xinaovo/TommyDSP/README.md

# TommyDSP

An audio DSP platform based on RP2350 microcontroller
