xinaovo/TommyDSP/hardware/TommyDSP/TommyDSP.kicad_pcb

## KiCad design hardware/TommyDSP/TommyDSP.kicad_pcb (2026-04-24)

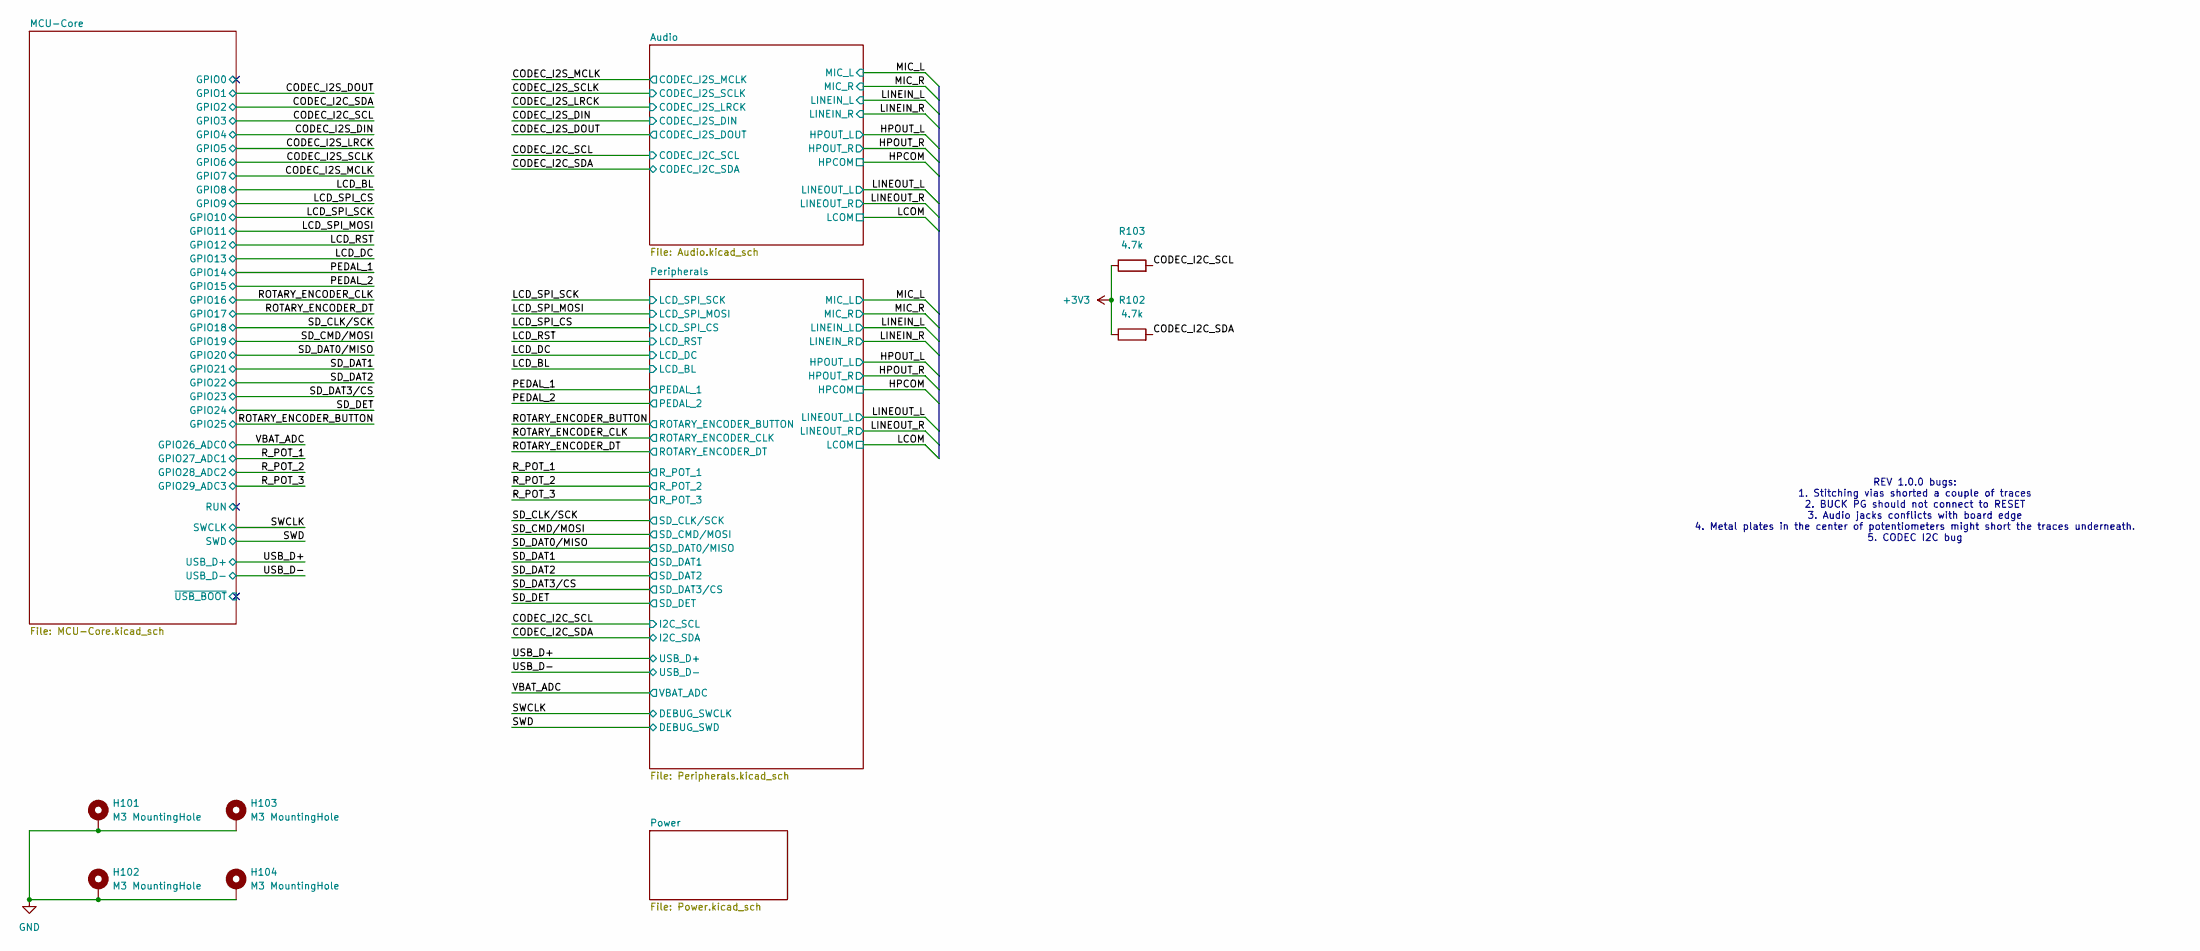
[picture p1: schematic TommyDSP.kicad_sch]

Parts:
H101, H102, H103, H104: M3 MountingHole; MountingHole_3.2mm_M3_DIN965_Pad_TopBottom
R102, R103: 4.7k; R_0603_1608Metric

Connections:
+3V3: R102.1, R103.1; also elsewhere on the board
/CODEC_I2C_SCL: R103.2; also elsewhere on the board
/CODEC_I2C_SDA: R102.2; also elsewhere on the board
GND: H101.1 (1_1), H102.1 (1_1), H103.1 (1_1), H104.1 (1_1); also elsewhere on the board

Notes on the sheet:
REV 1.0.0 bugs: 1. Stitching vias shorted a couple of traces 2. BUCK PG should not connect to RESET 3. Audio jacks conflicts with board edge 4. Metal plates in the center of potentiometers might short the traces underneath. 5. CODEC I2C bug

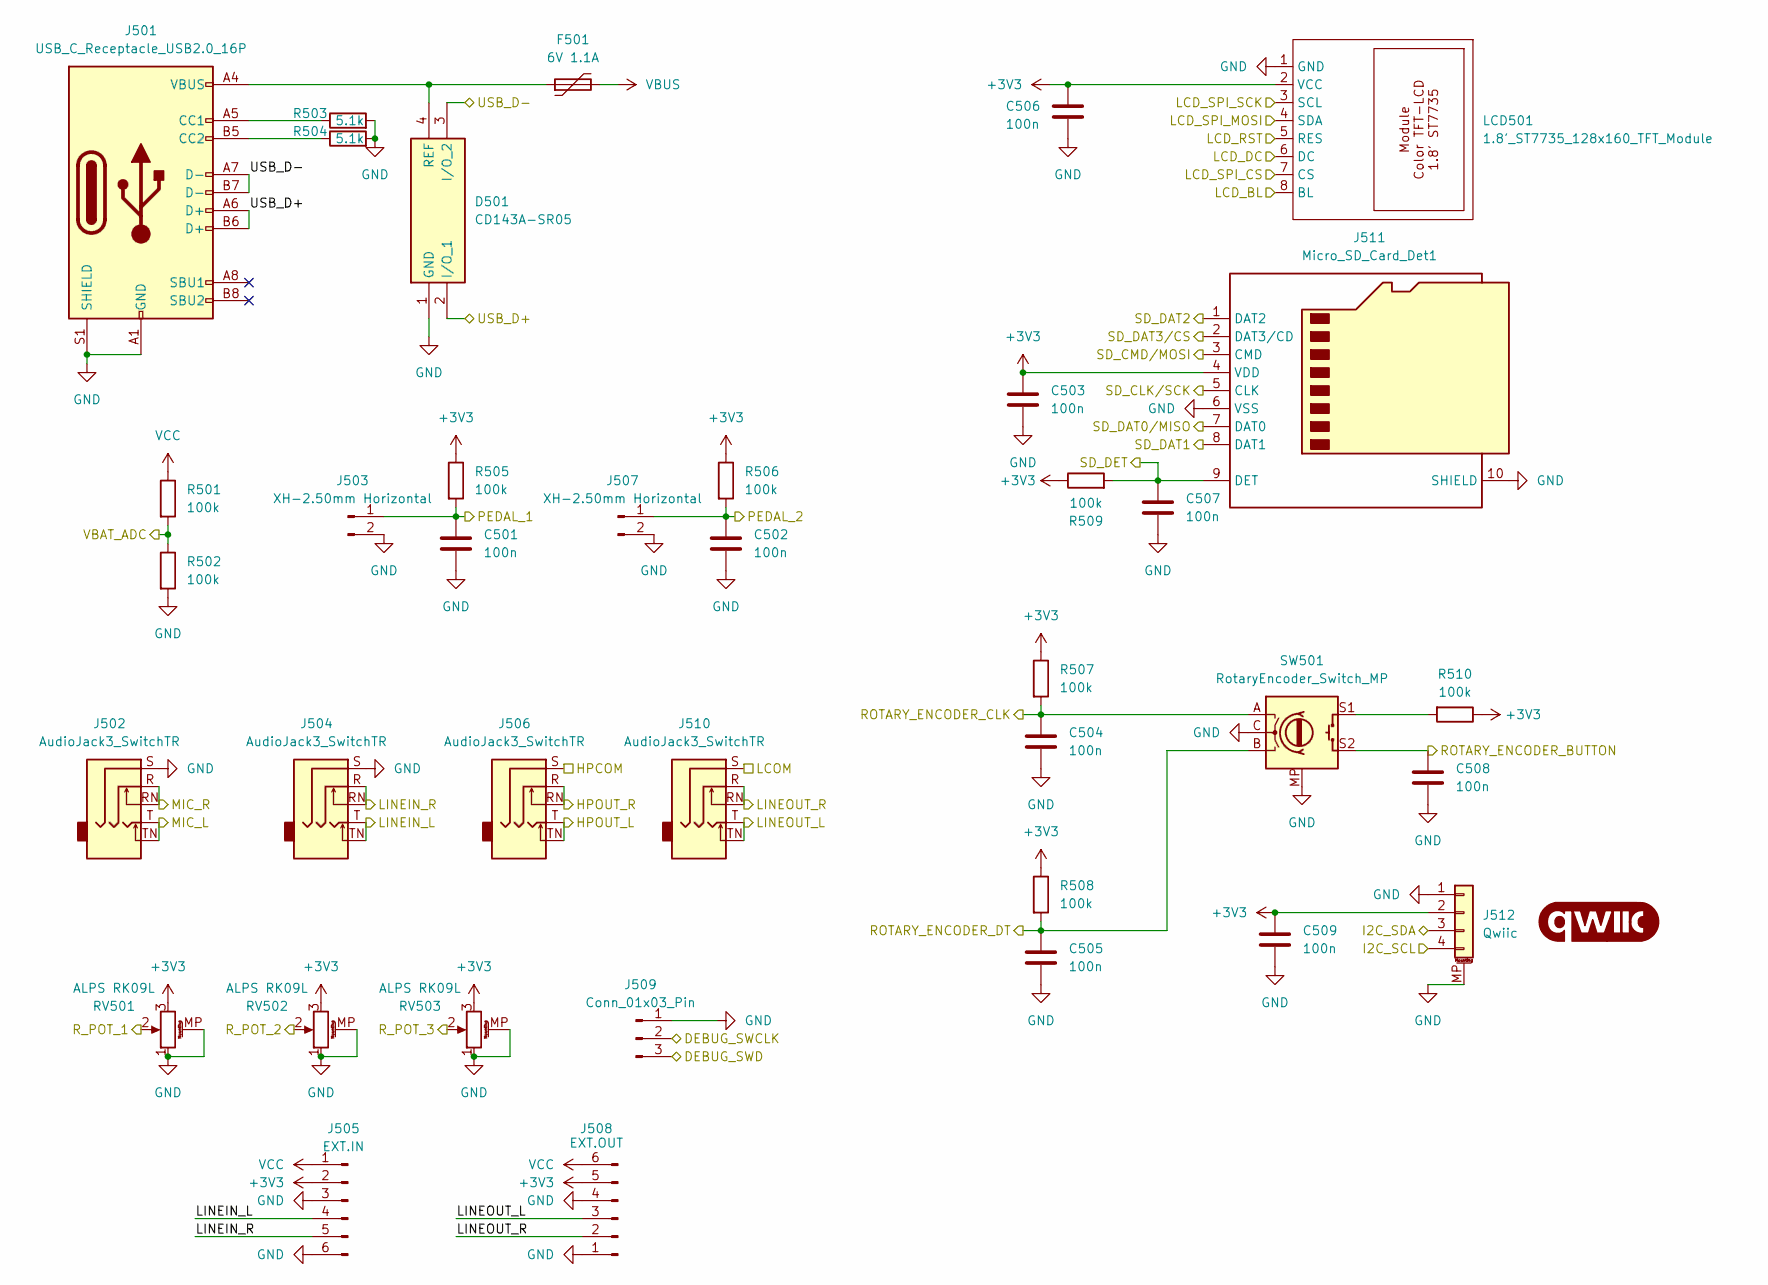
[picture p2: schematic Peripherals.kicad_sch, TommyDSP]

Parts:
C501, C502, C503, C504, C505, C506, C507, C508, C509: 100n; C_0603_1608Metric
D501: CD143A-SR05; CD143ASR05; Manufacturer_Part_Number CD143A-SR05; Mouser Part Number 652-CD143A-SR05
F501: 6V 1.1A; Fuse_1206_3216Metric
G501: qwiic_Logo; qwiic_5.5mm
J501: USB_C_Receptacle_USB2.0_16P; USB_C_Receptacle_G-Switch_GT-USB-7010ASV
J502, J504, J506, J510: AudioJack3_SwitchTR; Jack_3.5mm_CUI_SJ1-3525N_Horizontal
J503, J507: XH-2.50mm Horizontal; JST_EH_S2B-EH_1x02_P2.50mm_Horizontal
J505: EXT.IN; JST_XH_S6B-XH-A-1_1x06_P2.50mm_Horizontal
J508: EXT.OUT; JST_XH_S6B-XH-A-1_1x06_P2.50mm_Horizontal
J509: Conn_01x03_Pin; PinHeader_1x03_P2.54mm_Vertical
J511: Micro_SD_Card_Det1; TF01A
J512: Qwiic; JST_SH_SM04B-SRSS-TB_1x04-1MP_P1.00mm_Horizontal
LCD501: 1.8'_ST7735_128x160_TFT_Module
R501, R502, R505, R506, R507, R508, R509, R510: 100k; R_0603_1608Metric
R503, R504: 5.1k; R_0603_1608Metric
RV501, RV502, RV503: ALPS RK09L; Potentiometer_Alps_RK09K_Single_Vertical
SW501: RotaryEncoder_Switch_MP; RotaryEncoder_Alps_EC11E-Switch_Vertical_H20mm

Connections:
+3V3: C503.1, C506.1, C509.1, J505.2, J508.5, J511.4 (VDD), J512.2, LCD501.2 (VCC), R505.1, R506.1, R507.1, R508.1, R509.1, R510.1, RV501.3, RV502.3, RV503.3; also elsewhere on the board
/CODEC_I2C_SCL: J512.4; also elsewhere on the board
/CODEC_I2C_SDA: J512.3; also elsewhere on the board
/HPOUT_L: J506.T, J506.TN; also elsewhere on the board
/HPOUT_R: J506.R, J506.RN; also elsewhere on the board
/LCD_BL: LCD501.8 (BL); also elsewhere on the board
/LCD_DC: LCD501.6 (DC); also elsewhere on the board
/LCD_RST: LCD501.5 (RES); also elsewhere on the board
/LCD_SPI_CS: LCD501.7 (CS); also elsewhere on the board
/LCD_SPI_MOSI: LCD501.4 (SDA); also elsewhere on the board
/LCD_SPI_SCK: LCD501.3 (SCL); also elsewhere on the board
/LINEIN_L: J504.T, J504.TN, J505.4; also elsewhere on the board
/LINEIN_R: J504.R, J504.RN, J505.5; also elsewhere on the board
/LINEOUT_L: J508.3, J510.T, J510.TN; also elsewhere on the board
/LINEOUT_R: J508.2, J510.R, J510.RN; also elsewhere on the board
/MIC_L: J502.T, J502.TN; also elsewhere on the board
/MIC_R: J502.R, J502.RN; also elsewhere on the board
/PEDAL_1: C501.1, J503.1, R505.2; also elsewhere on the board
/PEDAL_2: C502.1, J507.1, R506.2; also elsewhere on the board
/ROTARY_ENCODER_BUTTON: C508.1, SW501.S2; also elsewhere on the board
/ROTARY_ENCODER_CLK: C504.1, R507.2, SW501.A; also elsewhere on the board
/ROTARY_ENCODER_DT: C505.1, R508.2, SW501.B; also elsewhere on the board
/R_POT_1: RV501.2; also elsewhere on the board
/R_POT_2: RV502.2; also elsewhere on the board
/R_POT_3: RV503.2; also elsewhere on the board
/SD_CLK/SCK: J511.5 (CLK); also elsewhere on the board
/SD_CMD/MOSI: J511.3 (CMD); also elsewhere on the board
/SD_DAT0/MISO: J511.7 (DAT0); also elsewhere on the board
/SD_DAT1: J511.8 (DAT1); also elsewhere on the board
/SD_DAT2: J511.1 (DAT2); also elsewhere on the board
/SD_DAT3/CS: J511.2 (DAT3/CD); also elsewhere on the board
/SD_DET: C507.1, J511.9 (DET), R509.2; also elsewhere on the board
/SWCLK: J509.2; also elsewhere on the board
/SWD: J509.3; also elsewhere on the board
/USB_D+: D501.2 (I/O_1), J501.A6 (D+_A6), J501.B6 (D+_B6); also elsewhere on the board
/USB_D-: D501.3 (I/O_2), J501.A7 (D-_A7), J501.B7 (D-_B7); also elsewhere on the board
/VBAT_ADC: R501.2, R502.1; also elsewhere on the board
GND: C501.2, C502.2, C503.2, C504.2, C505.2, C506.2, C507.2, C508.2, C509.2, D501.1 (GND), J501.A1 (GND_A1), J501.A12 (GND_A12), J501.B1 (GND_B1), J501.B12 (GND_B12), J501.S1 (SHIELD), J501.SH (SHIELD_S1), J502.S, J503.2, J504.S, J505.3, J505.6, J506.S, J507.2, J508.1, J508.4, J509.1, J510.S, J511.6 (VSS), J511.10 (SHIELD), J512.1, J512.MP (MountPin), LCD501.1 (GND), R502.2, R503.2, R504.2, RV501.1, RV501.MP (MountPin), RV502.1, RV502.MP (MountPin), RV503.1, RV503.MP (MountPin), SW501.C, SW501.MP; also elsewhere on the board
unnamed: D501.4 (REF), F501.1, J501.A4 (VBUS_A4), J501.A9 (VBUS_A9), J501.B4 (VBUS_B4), J501.B9 (VBUS_B9)
unnamed: J501.A5 (CC1_A5), R503.1
unnamed: J501.B5 (CC2_B5), R504.1
unnamed: R510.2, SW501.S1
VBUS: F501.2; also elsewhere on the board
VCC: J505.1, J508.6, R501.1; also elsewhere on the board

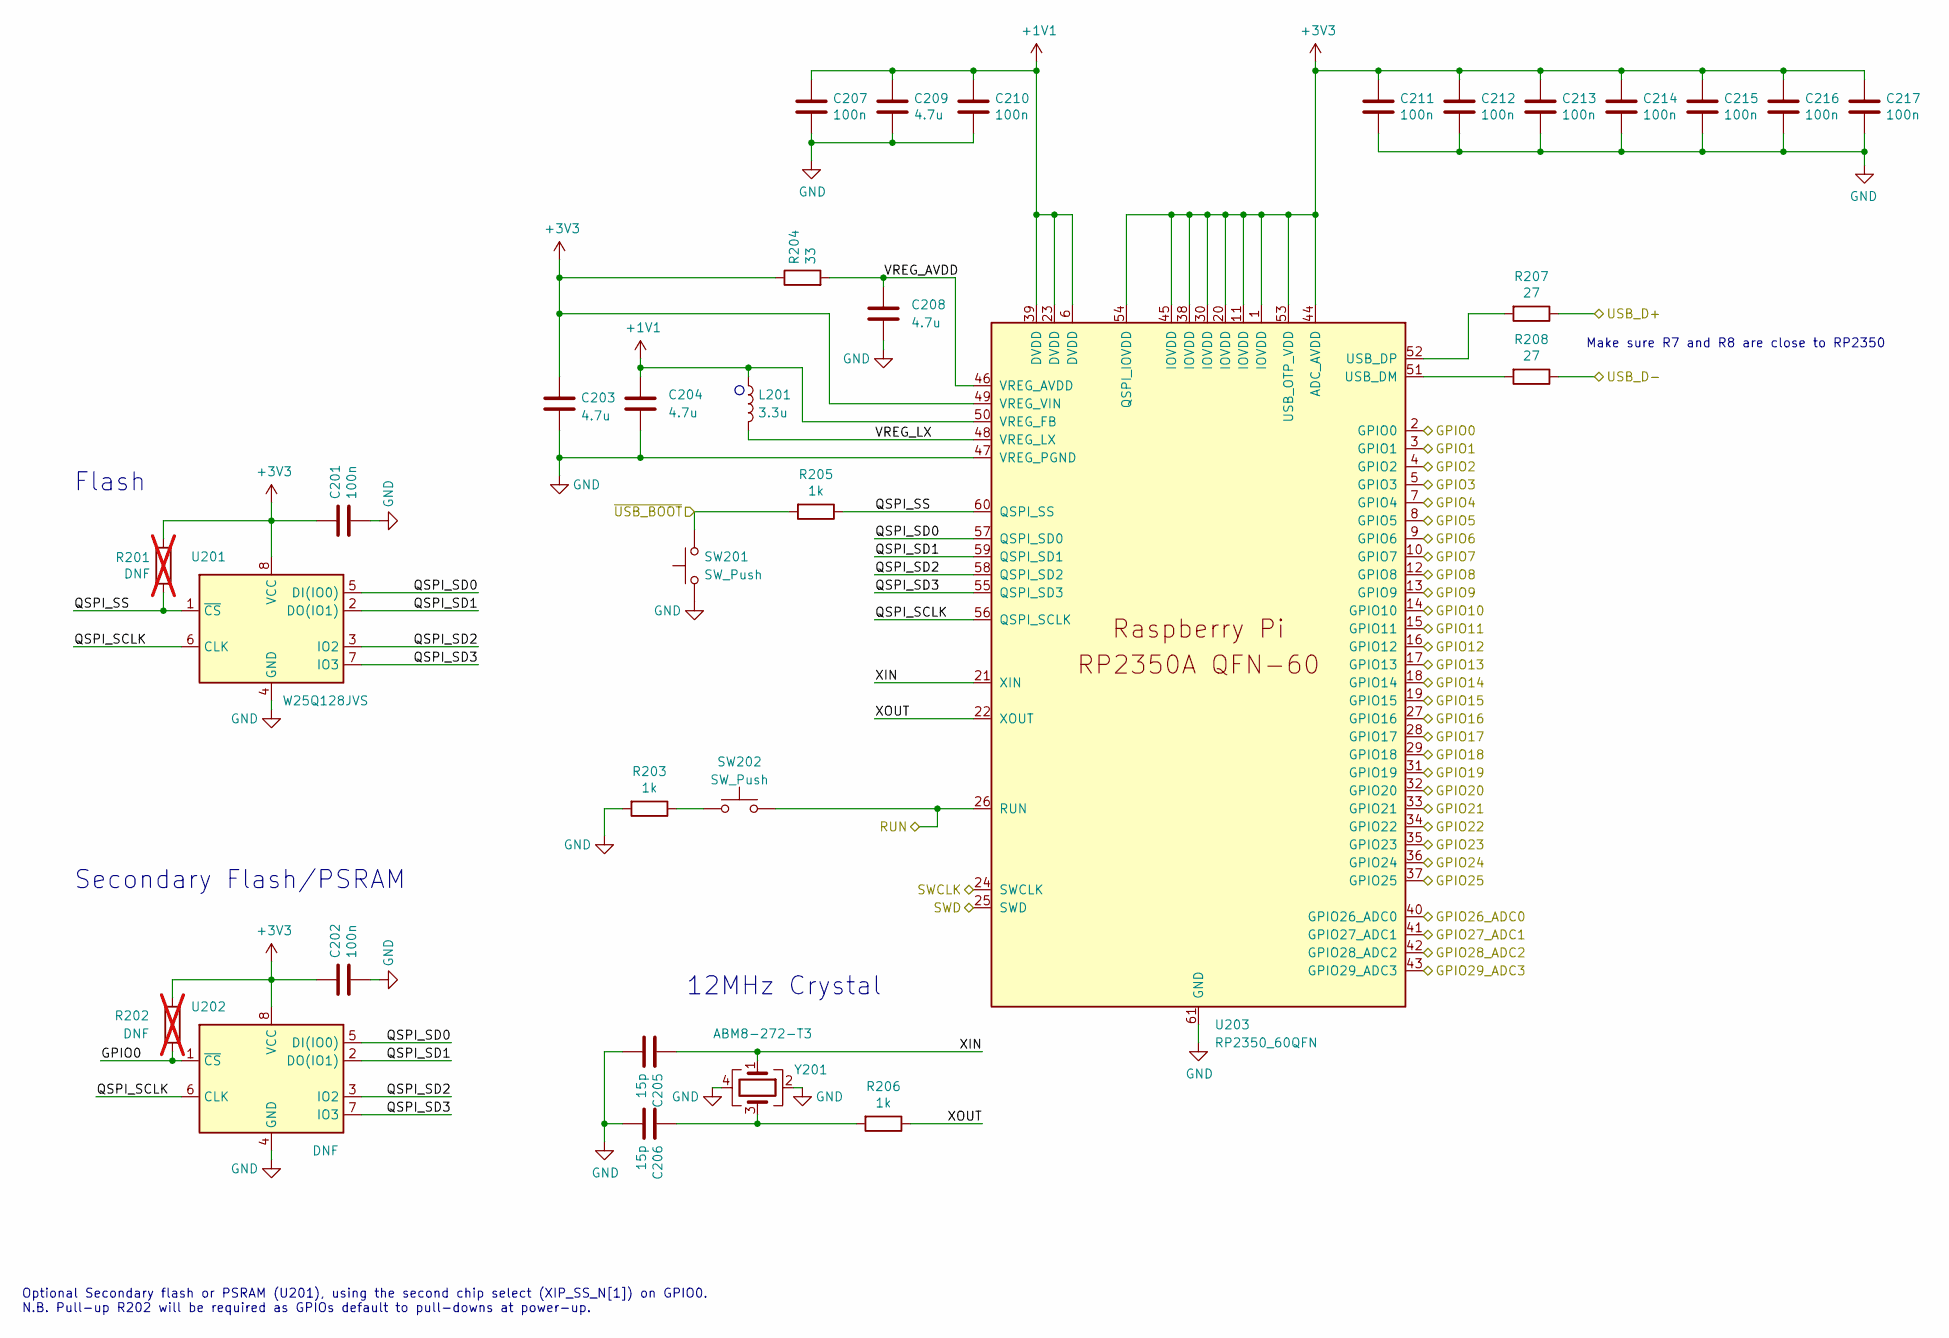
[picture p3: schematic MCU-Core.kicad_sch, TommyDSP]

Parts:
C201, C202: 100n; C_0603_1608Metric
C203, C204: 4.7u; C_0402_1005Metric_small_pads
C205, C206: 15p; C_0603_1608Metric
C207, C210, C211, C212, C213, C214, C215, C216, C217: 100n; C_0402_1005Metric
C208: 4.7u; C_0603_1608Metric
C209: 4.7u; C_0402_1005Metric
L201: 3.3u; L_pol_2016
R201, R202: DNF; R_0603_1608Metric; not fitted
R203, R205, R206: 1k; R_0603_1608Metric
R204: 33; R_0603_1608Metric
R207, R208: 27; R_0603_1608Metric
SW201, SW202: SW_Push; SW_SPST_CK_RS282G05A3
U201: W25Q128JVS; SOIC-8_5.3x5.3mm_P1.27mm
U202: DNF; SOIC-8_5.3x5.3mm_P1.27mm
U203: RP2350_60QFN; RP2350-QFN-60-1EP_7x7_P0.4mm_EP3.4x3.4mm_ThermalVias
Y201: ABM8-272-T3; Crystal_SMD_3225-4Pin_3.2x2.5mm

Connections:
+1V1: C204.1, C207.1, C209.1, C210.1, L201.1, U203.6 (DVDD), U203.23 (DVDD), U203.39 (DVDD), U203.50 (VREG_FB)
+3V3: C201.1, C202.1, C203.1, C211.1, C212.1, C213.1, C214.1, C215.1, C216.1, C217.1, R201.1, R202.1, R204.1, U201.8 (VCC), U202.8 (VCC), U203.1 (IOVDD), U203.11 (IOVDD), U203.20 (IOVDD), U203.30 (IOVDD), U203.38 (IOVDD), U203.44 (ADC_AVDD), U203.45 (IOVDD), U203.49 (VREG_VIN), U203.53 (USB_OTP_VDD), U203.54 (QSPI_IOVDD); also elsewhere on the board
/CODEC_I2C_SCL: U203.5 (GPIO3); also elsewhere on the board
/CODEC_I2C_SDA: U203.4 (GPIO2); also elsewhere on the board
/CODEC_I2S_DIN: U203.7 (GPIO4); also elsewhere on the board
/CODEC_I2S_DOUT: U203.3 (GPIO1); also elsewhere on the board
/CODEC_I2S_LRCK: U203.8 (GPIO5); also elsewhere on the board
/CODEC_I2S_MCLK: U203.10 (GPIO7); also elsewhere on the board
/CODEC_I2S_SCLK: U203.9 (GPIO6); also elsewhere on the board
/LCD_BL: U203.12 (GPIO8); also elsewhere on the board
/LCD_DC: U203.17 (GPIO13); also elsewhere on the board
/LCD_RST: U203.16 (GPIO12); also elsewhere on the board
/LCD_SPI_CS: U203.13 (GPIO9); also elsewhere on the board
/LCD_SPI_MOSI: U203.15 (GPIO11); also elsewhere on the board
/LCD_SPI_SCK: U203.14 (GPIO10); also elsewhere on the board
/MCU-Core/GPIO0: R202.2, U202.1 (~CS), U203.2 (GPIO0)
/MCU-Core/QSPI_SCLK: U201.6 (CLK), U202.6 (CLK), U203.56 (QSPI_SCLK)
/MCU-Core/QSPI_SD0: U201.5 (DI(IO0)), U202.5 (DI(IO0)), U203.57 (QSPI_SD0)
/MCU-Core/QSPI_SD1: U201.2 (DO(IO1)), U202.2 (DO(IO1)), U203.59 (QSPI_SD1)
/MCU-Core/QSPI_SD2: U201.3 (IO2), U202.3 (IO2), U203.58 (QSPI_SD2)
/MCU-Core/QSPI_SD3: U201.7 (IO3), U202.7 (IO3), U203.55 (QSPI_SD3)
/MCU-Core/QSPI_SS: R201.2, R205.1, U201.1 (~CS), U203.60 (QSPI_SS)
/MCU-Core/RUN: SW202.2, U203.26 (RUN)
/MCU-Core/VREG_AVDD: C208.1, R204.2, U203.46 (VREG_AVDD)
/MCU-Core/VREG_LX: L201.2, U203.48 (VREG_LX)
/MCU-Core/XIN: C205.1, U203.21 (XIN), Y201.1
/MCU-Core/XOUT: R206.1, U203.22 (XOUT)
/MCU-Core/~USB_BOOT: R205.2, SW201.2
/PEDAL_1: U203.18 (GPIO14); also elsewhere on the board
/PEDAL_2: U203.19 (GPIO15); also elsewhere on the board
/ROTARY_ENCODER_BUTTON: U203.37 (GPIO25); also elsewhere on the board
/ROTARY_ENCODER_CLK: U203.27 (GPIO16); also elsewhere on the board
/ROTARY_ENCODER_DT: U203.28 (GPIO17); also elsewhere on the board
/R_POT_1: U203.41 (GPIO27_ADC1); also elsewhere on the board
/R_POT_2: U203.42 (GPIO28_ADC2); also elsewhere on the board
/R_POT_3: U203.43 (GPIO29_ADC3); also elsewhere on the board
/SD_CLK/SCK: U203.29 (GPIO18); also elsewhere on the board
/SD_CMD/MOSI: U203.31 (GPIO19); also elsewhere on the board
/SD_DAT0/MISO: U203.32 (GPIO20); also elsewhere on the board
/SD_DAT1: U203.33 (GPIO21); also elsewhere on the board
/SD_DAT2: U203.34 (GPIO22); also elsewhere on the board
/SD_DAT3/CS: U203.35 (GPIO23); also elsewhere on the board
/SD_DET: U203.36 (GPIO24); also elsewhere on the board
/SWCLK: U203.24 (SWCLK); also elsewhere on the board
/SWD: U203.25 (SWD); also elsewhere on the board
/USB_D+: R207.1; also elsewhere on the board
/USB_D-: R208.1; also elsewhere on the board
/VBAT_ADC: U203.40 (GPIO26_ADC0); also elsewhere on the board
GND: C201.2, C202.2, C203.2, C204.2, C205.2, C206.2, C207.2, C208.2, C209.2, C210.2, C211.2, C212.2, C213.2, C214.2, C215.2, C216.2, C217.2, R203.2, SW201.1, U201.4 (GND), U202.4 (GND), U203.47 (VREG_PGND), U203.61 (GND), Y201.2, Y201.4; also elsewhere on the board
unnamed: C206.1, R206.2, Y201.3
unnamed: R203.1, SW202.1
unnamed: R208.2, U203.51 (USB_DM)
unnamed: R207.2, U203.52 (USB_DP)

Notes on the sheet:
Make sure R7 and R8 are close to RP2350
12MHz Crystal
Optional Secondary flash or PSRAM (U201), using the second chip select (XIP_SS_N[1]) on GPIO0. N.B. Pull-up R202 will be required as GPIOs default to pull-downs at power-up.
Flash
Secondary Flash/PSRAM

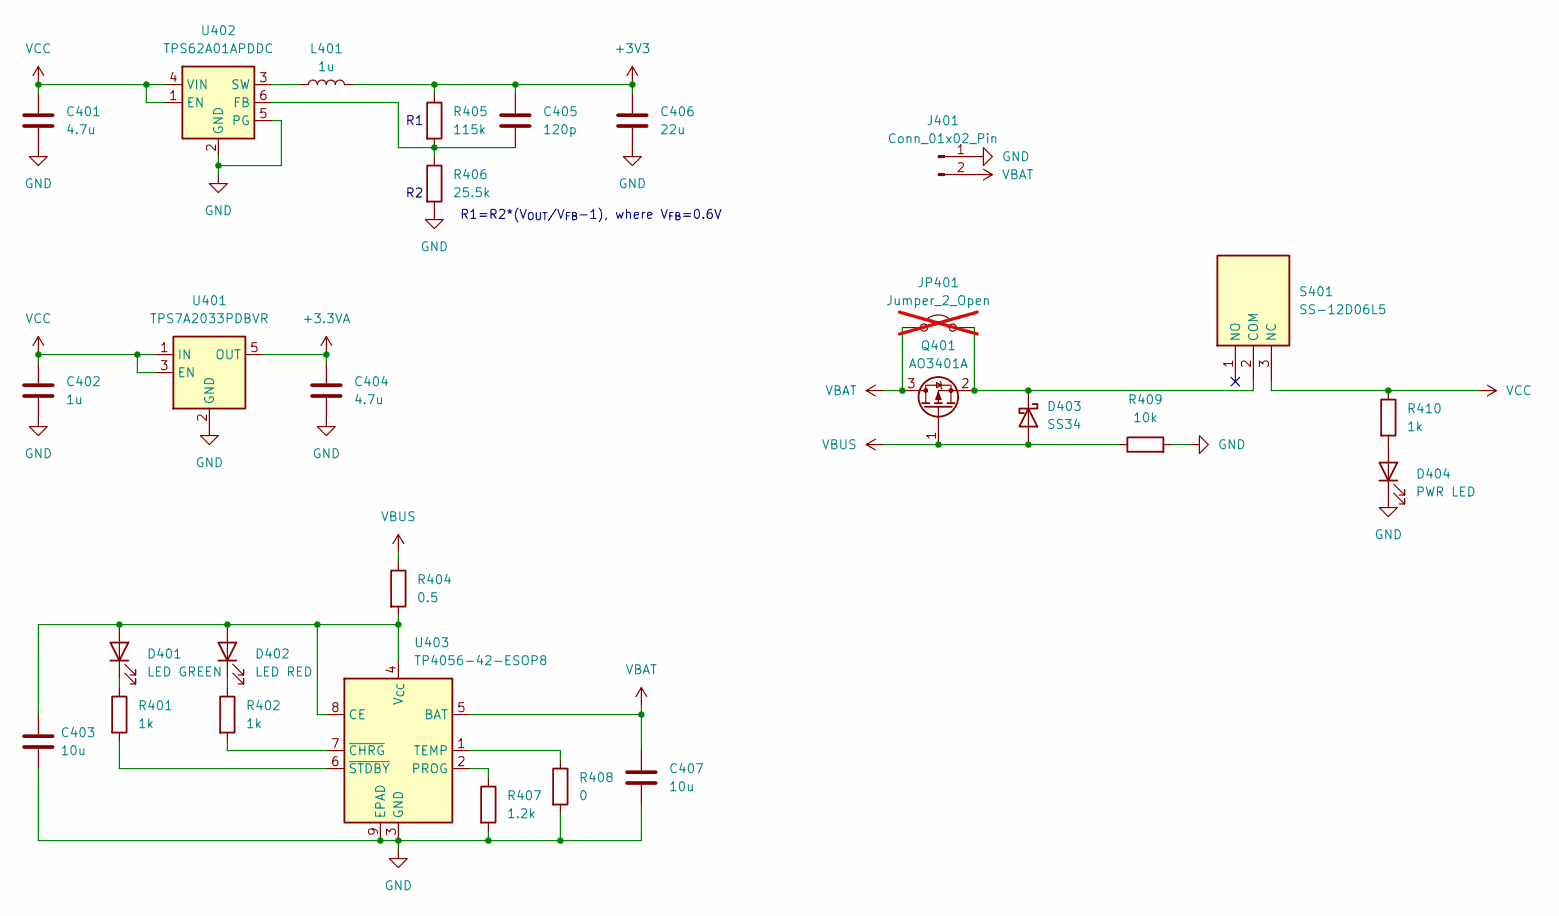
[picture p4: schematic Power.kicad_sch, TommyDSP]

Parts:
C401, C404: 4.7u; C_0603_1608Metric
C402: 1u; C_0603_1608Metric
C403, C407: 10u; C_0603_1608Metric
C405: 120p; C_0603_1608Metric
C406: 22u; C_0603_1608Metric
D401: LED GREEN; LED_0603_1608Metric
D402: LED RED; LED_0603_1608Metric
D403: SS34; D_SMA
D404: PWR LED; LED_D5.0mm
J401: Conn_01x02_Pin; JST_XH_B2B-XH-A_1x02_P2.50mm_Vertical
JP401: Jumper_2_Open; TestPoint_2Pads_Pitch2.54mm_Drill0.8mm; not fitted
L401: 1u; L_APV_ANR4020
Q401: AO3401A; SOT-23
R401, R402, R410: 1k; R_0603_1608Metric
R404: 0.5; R_1210_3225Metric
R405: 115k; R_0603_1608Metric
R406: 25.5k; R_0603_1608Metric
R407: 1.2k; R_0603_1608Metric
R408: 0; R_0603_1608Metric
R409: 10k; R_0603_1608Metric
S401: SS-12D06L5; SS12D06L5; Manufacturer_Part_Number SS-12D06L5
U401: TPS7A2033PDBVR; SOT-23-5
U402: TPS62A01APDDC; SOT-23-6
U403: TP4056-42-ESOP8; SOIC-8-1EP_3.9x4.9mm_P1.27mm_EP2.41x3.3mm_ThermalVias

Connections:
+3.3VA: C404.1, U401.5 (OUT); also elsewhere on the board
+3V3: C405.1, C406.1, L401.2, R405.1; also elsewhere on the board
GND: C401.2, C402.2, C403.2, C404.2, C406.2, C407.2, D404.1 (K), J401.1, R406.2, R407.2, R408.2, R409.2, U401.2 (GND), U402.2 (GND), U402.5 (PG), U403.3 (GND), U403.9 (EPAD); also elsewhere on the board
unnamed: C403.1, D401.2 (A), D402.2 (A), R404.2, U403.4 (V_{CC}), U403.8 (CE)
unnamed: D401.1 (K), R401.1
unnamed: D402.1 (K), R402.1
unnamed: D403.1 (K), JP401.2 (B), Q401.2 (S), S401.2 (COM)
unnamed: D404.2 (A), R410.2
unnamed: C405.2, R405.2, R406.1, U402.6 (FB)
unnamed: L401.1, U402.3 (SW)
unnamed: R407.1, U403.2 (PROG)
unnamed: R408.1, U403.1 (TEMP)
unnamed: R402.2, U403.7 (~CHRG)
unnamed: R401.2, U403.6 (~STDBY)
VBAT: C407.1, J401.2, JP401.1 (A), Q401.3 (D), U403.5 (BAT)
VBUS: D403.2 (A), Q401.1 (G), R404.1, R409.1; also elsewhere on the board
VCC: C401.1, C402.1, R410.1, S401.3 (NC), U401.1 (IN), U401.3 (EN), U402.1 (EN), U402.4 (VIN); also elsewhere on the board

Notes on the sheet:
R1=R2*(V_{OUT}/V_{FB}-1), where V_{FB}=0.6V
R1 R2

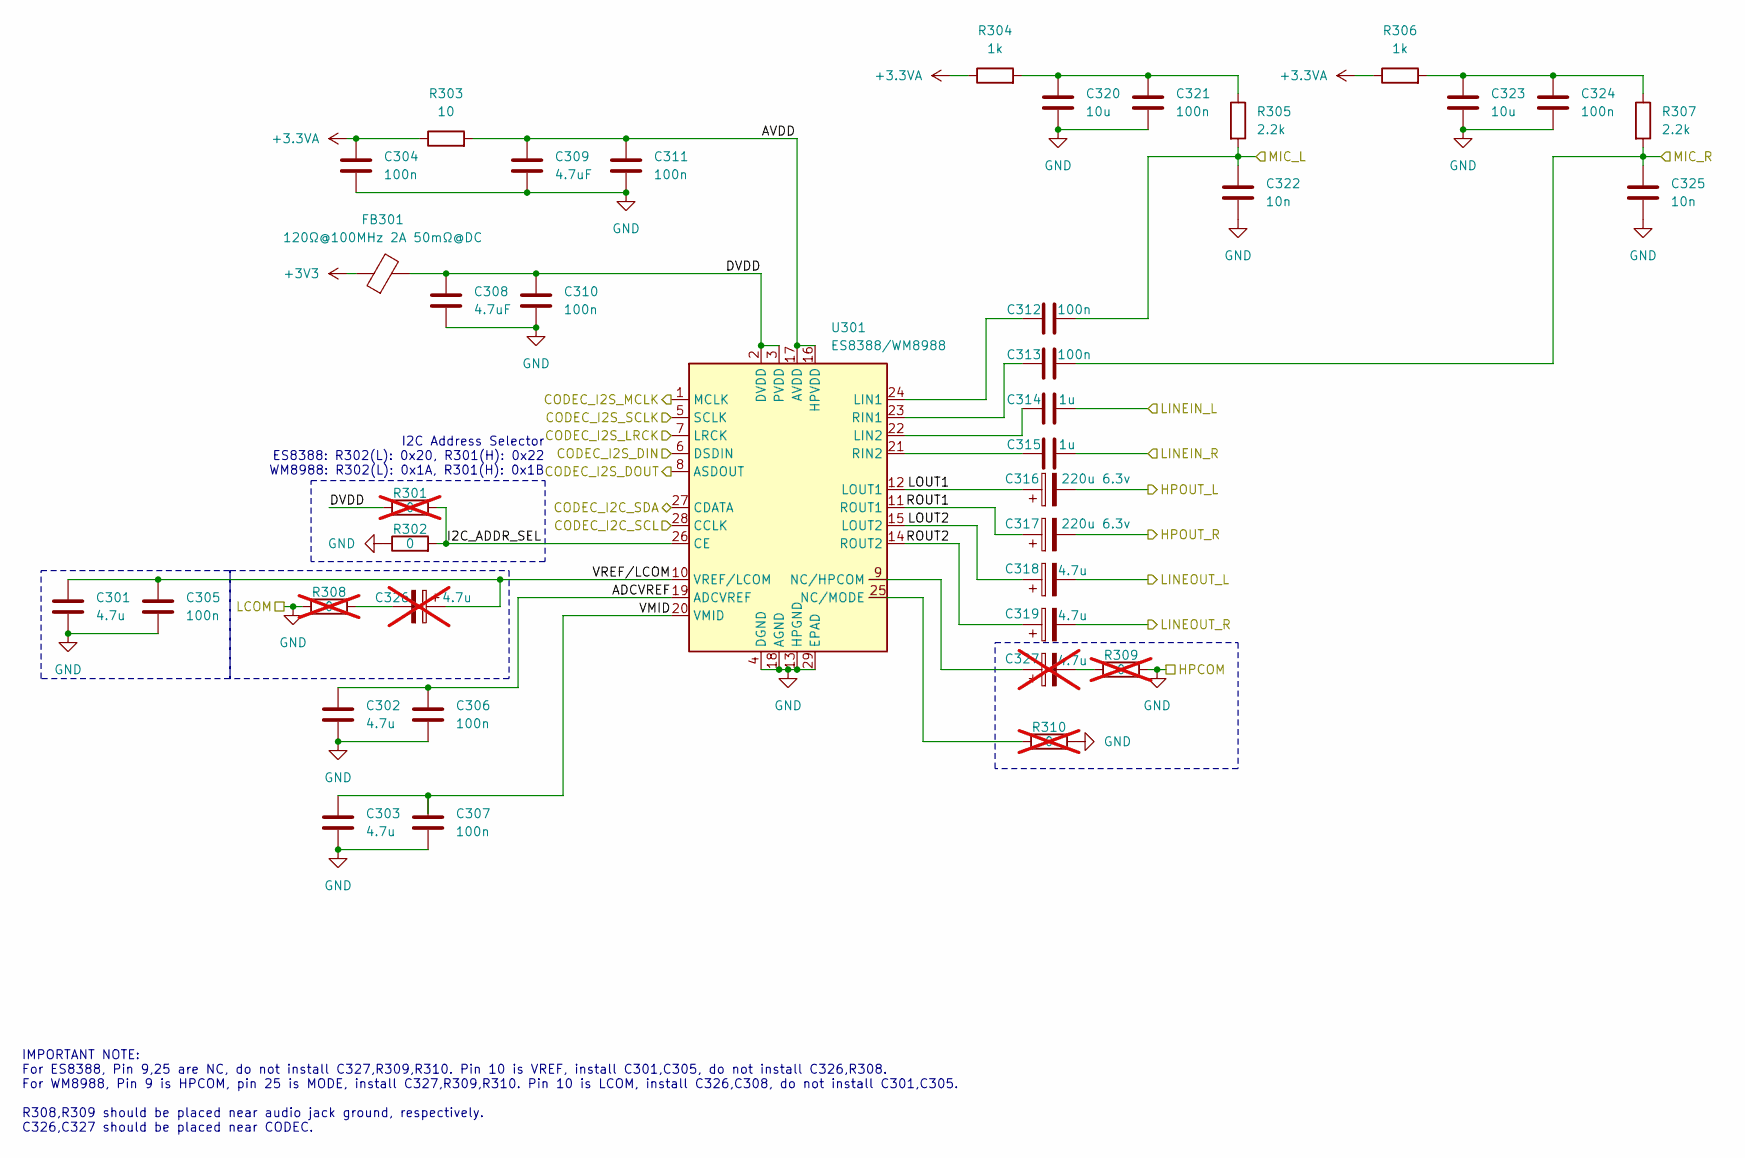
[picture p5: schematic Audio.kicad_sch, TommyDSP]

Parts:
C301, C302, C303: 4.7u; C_0603_1608Metric
C304, C305, C306, C307, C310, C311, C312, C313, C321, C324: 100n; C_0603_1608Metric
C308, C309: 4.7uF; C_0603_1608Metric
C314, C315: 1u; C_0603_1608Metric
C316, C317: 220u 6.3v; CP_Radial_D6.3mm_P2.50mm
C318, C319: 4.7u; CP_Radial_D5.0mm_P2.50mm
C320, C323: 10u; C_0603_1608Metric
C322, C325: 10n; C_0603_1608Metric
C326, C327: 4.7u; CP_Radial_D5.0mm_P2.50mm; not fitted
FB301: 120Ω@100MHz 2A 50mΩ@DC; L_0603_1608Metric
R301, R308, R309, R310: 0; R_0603_1608Metric; not fitted
R302: 0; R_0603_1608Metric
R303: 10; R_0603_1608Metric
R304, R306: 1k; R_0603_1608Metric
R305, R307: 2.2k; R_0603_1608Metric
U301: ES8388/WM8988; QFN-28-1EP_4x4mm_P0.45mm_EP2.6x2.6mm

Connections:
+3.3VA: C304.1, R303.1, R304.1, R306.1; also elsewhere on the board
+3V3: FB301.1; also elsewhere on the board
/Audio/ADCVREF: C302.1, C306.1, U301.19 (ADCVREF)
/Audio/AVDD: C309.1, C311.1, R303.2, U301.16 (HPVDD), U301.17 (AVDD)
/Audio/DVDD: C308.1, C310.1, FB301.2, R301.1, U301.2 (DVDD), U301.3 (PVDD)
/Audio/I2C_ADDR_SEL: R301.2, R302.2, U301.26 (CE)
/Audio/LOUT1: C316.1, U301.12 (LOUT1)
/Audio/LOUT2: C318.1, U301.15 (LOUT2)
/Audio/ROUT1: C317.1, U301.11 (ROUT1)
/Audio/ROUT2: C319.1, U301.14 (ROUT2)
/Audio/VMID: C303.1, C307.1, U301.20 (VMID)
/Audio/VREF/LCOM: C301.1, C305.1, C326.1, U301.10 (VREF/LCOM)
/CODEC_I2C_SCL: U301.28 (CCLK); also elsewhere on the board
/CODEC_I2C_SDA: U301.27 (CDATA); also elsewhere on the board
/CODEC_I2S_DIN: U301.6 (DSDIN); also elsewhere on the board
/CODEC_I2S_DOUT: U301.8 (ASDOUT); also elsewhere on the board
/CODEC_I2S_LRCK: U301.7 (LRCK); also elsewhere on the board
/CODEC_I2S_MCLK: U301.1 (MCLK); also elsewhere on the board
/CODEC_I2S_SCLK: U301.5 (SCLK); also elsewhere on the board
/HPOUT_L: C316.2; also elsewhere on the board
/HPOUT_R: C317.2; also elsewhere on the board
/LINEIN_L: C314.2; also elsewhere on the board
/LINEIN_R: C315.2; also elsewhere on the board
/LINEOUT_L: C318.2; also elsewhere on the board
/LINEOUT_R: C319.2; also elsewhere on the board
/MIC_L: C312.2, C322.1, R305.2; also elsewhere on the board
/MIC_R: C313.2, C325.1, R307.2; also elsewhere on the board
GND: C301.2, C302.2, C303.2, C304.2, C305.2, C306.2, C307.2, C308.2, C309.2, C310.2, C311.2, C320.2, C321.2, C322.2, C323.2, C324.2, C325.2, R302.1, R308.1, R309.2, R310.2, U301.4 (DGND), U301.13 (HPGND), U301.18 (AGND), U301.29 (EPAD); also elsewhere on the board
unnamed: C320.1, C321.1, R304.2, R305.1
unnamed: C323.1, C324.1, R306.2, R307.1
unnamed: C326.2, R308.2
unnamed: C327.2, R309.1
unnamed: C312.1, U301.24 (LIN1)
unnamed: C314.1, U301.22 (LIN2)
unnamed: C327.1, U301.9 (NC/HPCOM)
unnamed: R310.1, U301.25 (NC/MODE)
unnamed: C313.1, U301.23 (RIN1)
unnamed: C315.1, U301.21 (RIN2)

Notes on the sheet:
I2C Address Selector ES8388: R302(L): 0x20, R301(H): 0x22 WM8988: R302(L): 0x1A, R301(H): 0x1B
IMPORTANT NOTE: For ES8388, Pin 9,25 are NC, do not install C327,R309,R310. Pin 10 is VREF, install C301,C305, do not install C326,R308. For WM8988, Pin 9 is HPCOM, pin 25 is MODE, install C327,R309,R310. Pin 10 is LCOM, install C326,C308, do not install C301,C305. R308,R309 should be placed near a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

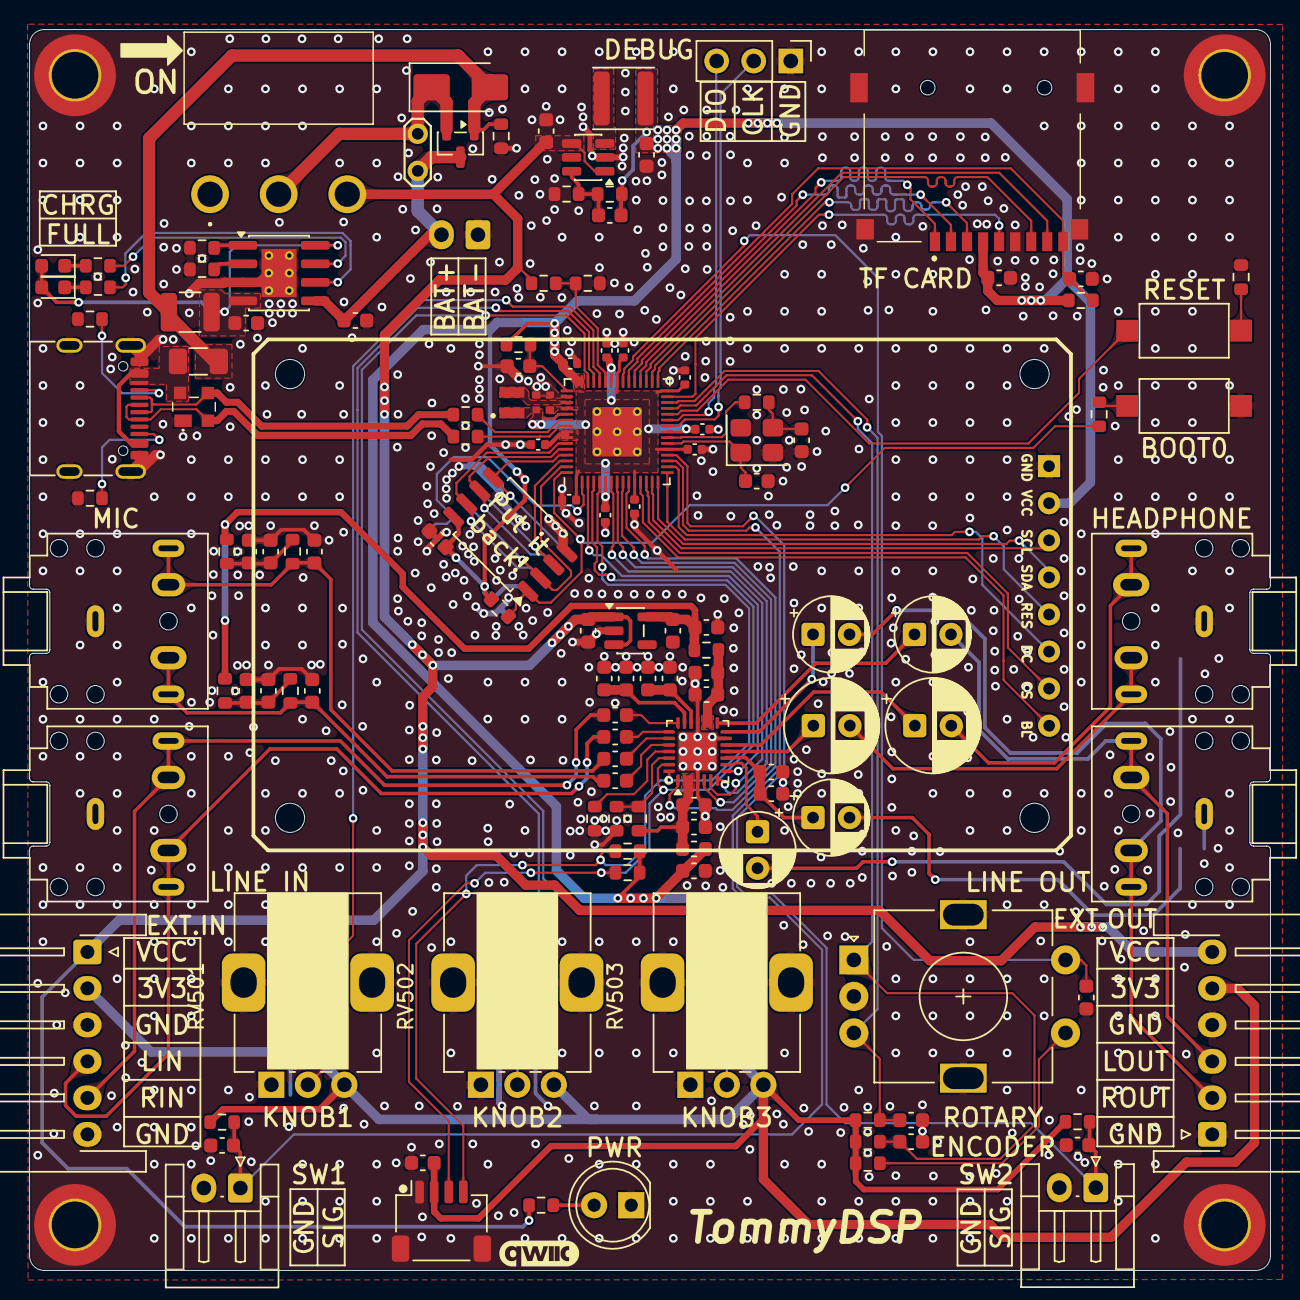
[picture p6: board TommyDSP.kicad_pcb from above]

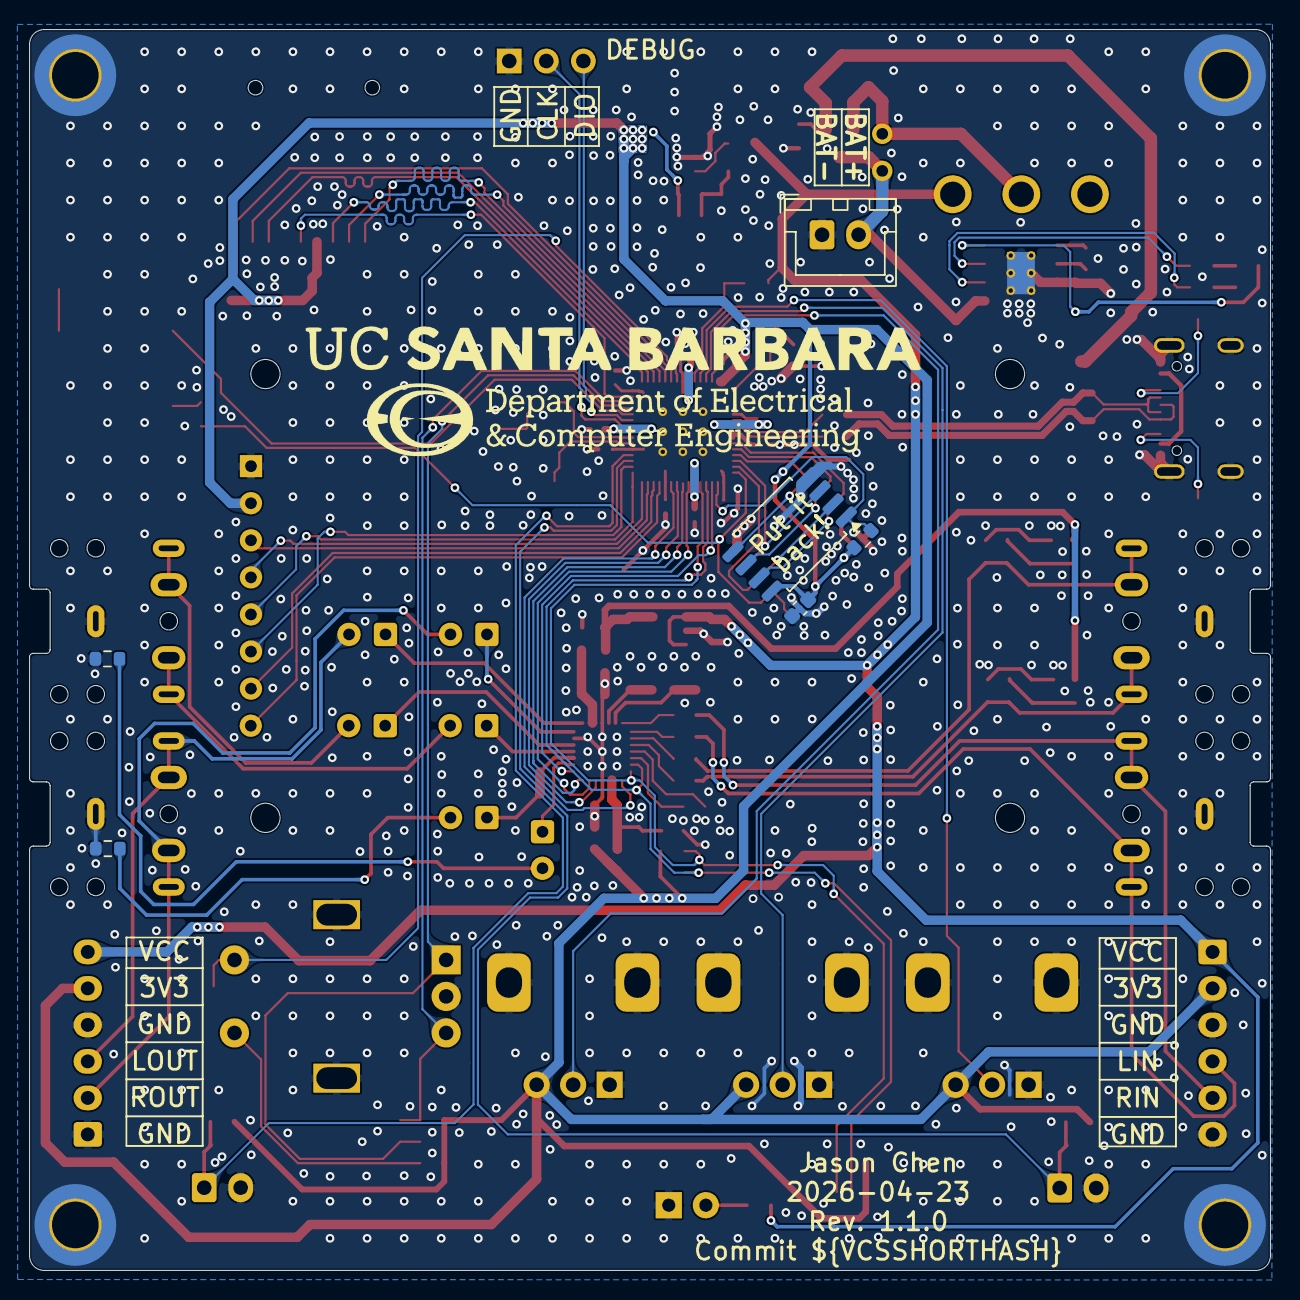
[picture p7: board TommyDSP.kicad_pcb from below]

Board: 2 copper layers, 85.0 x 85.0 mm, 144 parts (6 on the bottom side), 100 nets.
