xinaovo/TommyDSP/hardware/EXT-PAM8406-PA/EXT-PAM8406-PA.kicad_pcb

## KiCad design hardware/EXT-PAM8406-PA/EXT-PAM8406-PA.kicad_pcb (2026-02-27)

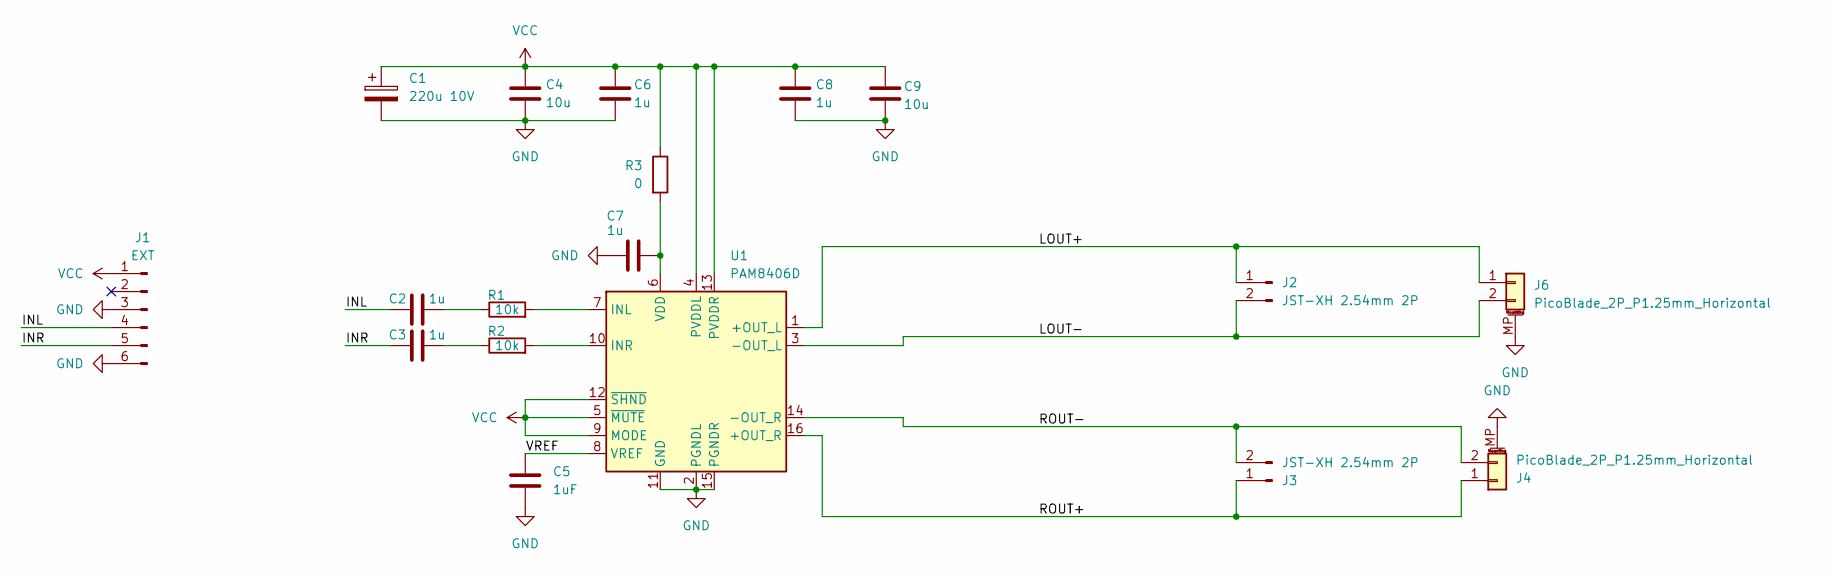
[picture p8: schematic EXT-PAM8406-PA.kicad_sch, PAM8406 Extension PA]

Parts:
C1: 220u 10V; C_Radial_D6.3mm_H7.0mm_P2.50mm
C2, C3, C6, C7, C8: 1u; C_0603_1608Metric
C4, C9: 10u; C_0603_1608Metric
C5: 1uF; C_0603_1608Metric
J1: EXT; JST_XH_S6B-XH-A-1_1x06_P2.50mm_Horizontal
J2, J3: JST-XH 2.54mm 2P; JST_XH_S2B-XH-A_1x02_P2.50mm_Horizontal
J4, J6: PicoBlade_2P_P1.25mm_Horizontal; Molex_PicoBlade_53261-0271_1x02-1MP_P1.25mm_Horizontal
R1, R2: 10k; R_0603_1608Metric
R3: 0; R_0603_1608Metric
U1: PAM8406D; SOIC-16_3.9x9.9mm_P1.27mm

Connections:
/INL: C2.1, J1.4
/INR: C3.1, J1.5
/LOUT+: J2.1, J6.1, U1.1 (+OUT_L)
/LOUT-: J2.2, J6.2, U1.3 (-OUT_L)
/ROUT+: J3.1, J4.1, U1.16 (+OUT_R)
/ROUT-: J3.2, J4.2, U1.14 (-OUT_R)
/VREF: C5.1, U1.8 (VREF)
GND: C1.2, C4.2, C5.2, C6.2, C7.1, C8.2, C9.2, J1.3, J1.6, J4.MP (MountPin), J6.MP (MountPin), U1.2 (PGNDL), U1.11 (GND), U1.15 (PGNDR)
unnamed: C2.2, R1.1
unnamed: C3.2, R2.1
unnamed: R1.2, U1.7 (INL)
unnamed: R2.2, U1.10 (INR)
unnamed: C7.2, R3.2, U1.6 (VDD)
VCC: C1.1, C4.1, C6.1, C8.1, C9.1, J1.1, R3.1, U1.4 (PVDDL), U1.5 (~MUTE), U1.9 (MODE), U1.12 (~SHND), U1.13 (PVDDR)

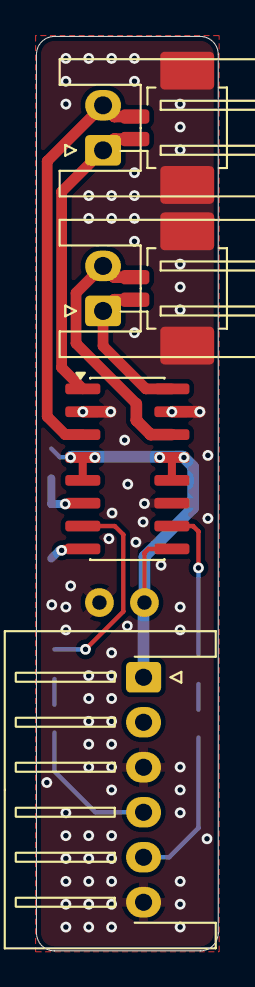
[picture p9: board EXT-PAM8406-PA.kicad_pcb from above]

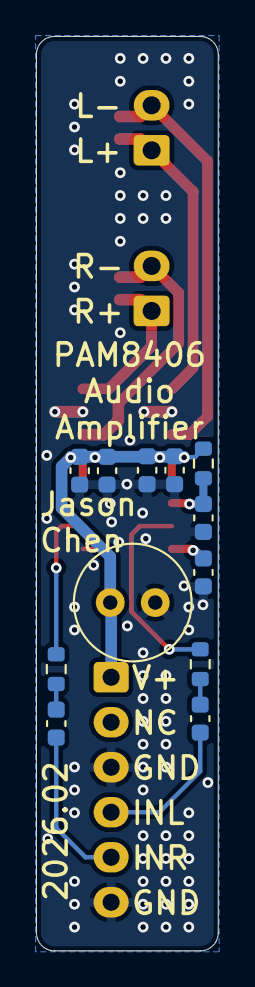
[picture p10: board EXT-PAM8406-PA.kicad_pcb from below]

Board: 2 copper layers, 10.1 x 50.8 mm, 18 parts (12 on the bottom side), 14 nets.
