xinaovo/TommyDSP/hardware/Qwiic2PinHeaders/Qwiic2PinHeaders.kicad_pcb

## KiCad design hardware/Qwiic2PinHeaders/Qwiic2PinHeaders.kicad_pcb (2026-02-27)

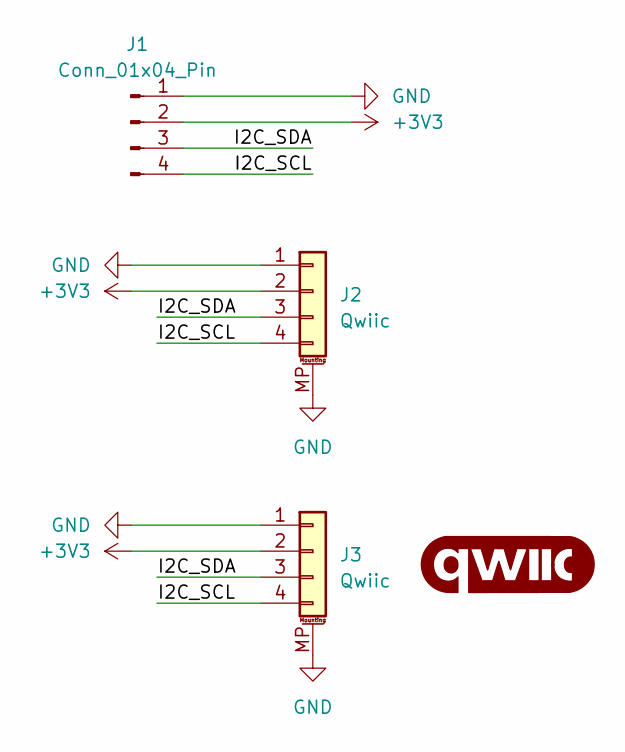
[picture p11: schematic Qwiic2PinHeaders.kicad_sch]

Parts:
G1: qwiic_Logo; qwiic_5.5mm
J1: Conn_01x04_Pin; PinHeader_1x04_P2.54mm_Vertical
J2, J3: Qwiic; JST_SH_SM04B-SRSS-TB_1x04-1MP_P1.00mm_Horizontal

Connections:
+3V3: J1.2, J2.2, J3.2
/I2C_SCL: J1.4, J2.4, J3.4
/I2C_SDA: J1.3, J2.3, J3.3
GND: J1.1, J2.1, J2.MP (MountPin), J3.1, J3.MP (MountPin)

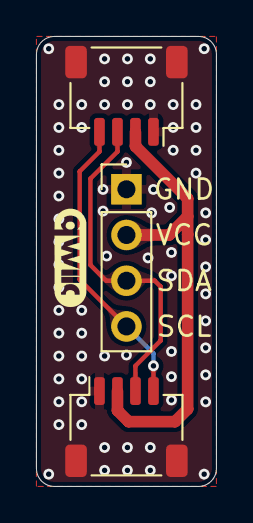
[picture p12: board Qwiic2PinHeaders.kicad_pcb from above]

Board: 2 copper layers, 10.0 x 25.0 mm, 4 parts (0 on the bottom side), 4 nets.
