xinaovo/TommyDSP/(commit log)

2026-01-31 add Microcontroller circuit
    [MCU-Core.kicad_sch, TommyDSP.kicad_pcb, TommyDSP.kicad_sch]
2026-02-06 add demo sketches, DAC works now but MIC doesn't work
    [I2S_OUTPUT_Frequency_Sweep.ino, I2S_OUTPUT_PCM.ino, wav2header.py]
2026-02-10 hardware: finished PCB routing
    [Audio.kicad_sch, MCU-Core.kicad_sch, Peripherals.kicad_sch, Power.kicad_sch, TommyDSP.kicad_pcb, TommyDSP.kicad_sch]
2026-02-11 hardware: finalize PCB design
    [Peripherals.kicad_sch, TommyDSP.kicad_pcb, TommyDSP.kicad_sch]
2026-02-11 hardware: minor silkscreen text adjustments
    [TommyDSP.kicad_pcb]
2026-02-12 hardware: fix incorrect audio jack symbol
    [TommyDSP.kicad_pcb]
2026-02-12 hardware: minor tweaks
    [TommyDSP.kicad_pcb]
2026-02-13 hardware: adjust value of BUCK feedback resistors
    [Audio.kicad_sch, Power.kicad_sch, TommyDSP.kicad_pcb, TommyDSP.kicad_sch]
2026-02-13 hardware: add compatibility for WM8988 CODEC
    [Audio.kicad_sch, Peripherals.kicad_sch, TommyDSP.kicad_pcb, TommyDSP.kicad_sch]
2026-02-13 hardware: modified audio page notes
    [Audio.kicad_sch]
2026-02-16 hardware: add PAM8406 audio amplifier board
    [Audio.kicad_sch, EXT-PAM8406-PA.kicad_pcb, EXT-PAM8406-PA.kicad_sch, TommyDSP.kicad_pcb]
2026-02-16 hardware: add Quiic2PinHeaders
    [Qwiic2PinHeaders.kicad_pcb, Qwiic2PinHeaders.kicad_sch]
2026-02-16 hardware: add USON2SOIC-8
    [USON2SOIC-8.kicad_pcb, USON2SOIC-8.kicad_sch]
2026-02-16 hardware: change cooper pour thermal relief settings for Qwiic2PinHeaders
    [Qwiic2PinHeaders.kicad_pcb]
2026-02-27 hardware: add misc project files
    [EXT-PAM8406-PA.kicad_pcb, MCU-Core.kicad_sch, PB-TMDSP.kicad_sch, Qwiic2PinHeaders.kicad_pcb, TommyDSP.kicad_pcb, USON2SOIC-8.kicad_pcb]
2026-02-27 software: add pitch shift effect demo
2026-02-27 software: add custom frequency-modulation-like pitch shift effect demo
2026-03-06 minor PCB optimization
    [TommyDSP.kicad_pcb]
2026-03-12 add pitch shifting recorder
2026-04-24 bump to KiCad V10, add logo
    [Audio.kicad_sch, MCU-Core.kicad_sch, Peripherals.kicad_sch, Power.kicad_sch, TommyDSP.kicad_pcb, TommyDSP.kicad_sch]
